vpodlesnyi/MainBoard/OUTPUT/BOM/Bill of Materials-MainBoard.xlsx

Description | Part Number | Value | Voltage | Designator | Quantity
 |  |  |  | M1, M2, M3, M4, M5, M6, M7 | 7
 | STM32F405RGT6 |  |  | DD1 | 1
3D accelerometer, 3D gyroscope, 3D magnetometer | LSM9DS1 |  |  | DD10 | 1
5-A, Wide Input Range, Step-Down Converter | TPS5450 |  |  | DD12 | 1
5-A, Wide Input Range, Step-Down Converter | TPS54560BQDDAQ1 |  |  | DD11, DD13 | 2
9-Port 10/100 Unmanaged Ethernet Switch | KSZ8999I |  |  | DD6 | 1
400-mA Low-Dropout Regulator with Reverse Current Protection | TPS73618DBV |  |  | DA4 | 1
Cтабилитрон (лавинный выпрямительный диод) односторонний | TPSMB56A |  |  | VD20, VD21 | 2
DC/DC преобразователь | P6AU/IU-3R305ELF |  |  | DD5, DD14 | 2
DIP переключатель |  |  |  | SW1, SW3, SW4 | 3
DIP переключатель |  |  |  | SW2 | 1
DIP переключатель |  |  |  | SW5 | 1
EMI Suppression Filter | B82477G4153M000 | 15мкГн |  | L5 | 1
EMI Suppression Filter | B82477G4223M000 | 22мкГн |  | L4 | 1
EMI Suppression Filter | H1164NL |  |  | T1 | 1
EMI Suppression Filter | SDR0604- 180YL | 18мкГн |  | L1, L7 | 2
EMI Suppression Filter | SDR1006-4R7ML | 4,7мкГн |  | L6 | 1
Isolated CAN Transceiver | ISO1050DW |  |  | DD3, DD4 | 2
SPI Serial Flash Memory | AT25DF021-SSH-B |  |  | DD2 | 1
TVS | PESD1CAN |  |  | DA1, DA2 | 2
TVS | SM712.TCT |  |  | DA3 | 1
Two-wire Serial EEPROM | AT24C02N-10SU-2.7 |  |  | DD7 | 1
USB 2.0 Hub and 10/100 Ethernet Controller | LAN9514I |  |  | DD8 | 1
Диод Шоттки | B560C |  |  | VD22, VD24, VD26 | 3
Диод Шоттки | MBR2H100SFT3G |  |  | VD27, VD28 | 2
Диод Шоттки | MBR0540 |  |  | VD1 | 1
Кварц. генер. 32.768 МГц (HCMOS/TTL) | KXO-V97 |  |  | G1 | 1
Кварц. генер. 32.768 МГц (HCMOS/TTL) | KXO-V97 25.0 MHz |  |  | G2, G3 | 2
Комплементарная сборка МОП | IRF7509TRPBF |  |  | VT1, VT2, VT3, VT4, VT5, VT6, VT7, VT8, VT9, VT10, VT11, VT12, VT13, VT14, VT15, VT16, VT17, VT18, VT19, VT20 | 20
Конденсатор | C3225X7R1H106K250AC | 10мк | 50В | C8, C87, C121, C128 | 4
Конденсатор | C4532C0G1H154J250KA | 0,15мк | 50В | C145, C163 | 2
Конденсатор | C4532X7R2A225M | 2,2мк | 100В | C147, C148, C149, C150, C164, C165, C166, C167 | 8
Конденсатор | CC1206KKX7RDBB471 | 470 | 2кВ | C27, C172 | 2
Конденсатор | GRM21AR72E472KW | 4700 | 250В | C143 | 1
Конденсатор | GRM21BZ71H475KE15L | 4,7мк | 50В | C156, C157 | 2
Конденсатор | GRM31CR72E104K | 0,1мк | 250В | C135, C136, C137, C138 | 4
Конденсатор | GRM155R71H102K* | 1000 | 50B | C94, C95, C98, C101 | 4
Конденсатор | GRM155R71H103K | 0,01мк | 50B | C15, C20, C120 | 3
Конденсатор | GRM155R71H103K | 0,01мк | 50B | C124, C125, C134, C153, C158, C159 | 6
Конденсатор | GRM155R71H104KE14D | 0,1мк | 50В | C3, C5, C6, C9, C10, C11, C12, C13, C14, C17, C18, C22, C23, C46, C47, C48, C49, C50, C51, C52, C53, C54, C55, C56, C57, C58, C59, C60, C61, C62, C63, C64, C65, C66, C67, C68, C69, C70, C71, C72, C73, C74, C75, C76, C79, C80, C89, C90, C91, C92, C93, C96, C97, C99, C100, C102, C103, C104, C105, C106, C107, C108, C109, C110, C111, C112, C113, C114, C115, C116, C117, C119, C122, C123, C126, C127, C129, C130, C131, C132, C133, C154, C155, C173, C174 | 85
Конденсатор | GRM155R71H104KE14D | 0,1мк | 50В | C144, C161 | 2
Конденсатор | GRM188R71C105KA12D** | 1мк | 16B | C4, C7, C16, C19, C21, C24, C88, C118 | 8
Конденсатор | GRM188R71H104KA93D | 0,1мк | 50B | C28, C29, C30, C31, C32, C33, C34, C35, C36, C37, C38, C39, C40, C41, C42, C43, C44, C45 | 18
Конденсатор | GRM188Z71C225ME43J | 2,2мк | 16B | C1, C2, C25, C26, C170, C171 | 6
Конденсатор | GRM1555C1H5R6C | 5,6 | 50B | C151 | 1
Конденсатор | GRM1555C1H102J | 1000 | 50B | C169 | 1
Конденсатор | GRM1555C1H391J | 390 | 50B | C168 | 1
Конденсатор | GRM1555C1H561J | 560 | 50B | C152 | 1
Конденсатор полярный | 293D107X9016D2TE3 | 100мк | 16В | C160 | 1
Конденсатор полярный | EEH-ZE1V151V | 150мк | 35В | C146 | 1
Конденсатор полярный | EEU-FS1K121LB | 120мк | 80В | C139, C140, C141, C142 | 4
Конденсатор полярный | TPSD157K010R0050 | 150мк | 10B | C162 | 1
Опторазвязка | FODM8801A |  |  | DA5, DA6 | 2
Приемопередатчик RS485 изолированный | ADM2582EBRWZ |  |  | DD9 | 1
Разъем - 2 конт. розетка | 559320210 |  |  | X24 | 1
Разъем - 2 конт. розетка | 559320210 |  |  | X25 | 1
Разъем - 3 конт. розетка | 559320310 |  |  | X11 | 1
Разъем - 3 конт. розетка | 559320310 |  |  | X13 | 1
Разъем - 3 конт. розетка | 559320310 |  |  | X14 | 1
Разъем - 3 конт. розетка | 559320310 |  |  | X15 | 1
Разъем - 3 конт. розетка | 559320310 |  |  | X16 | 1
Разъем - 3 конт. розетка | 559320310 |  |  | X17 | 1
Разъем - 3 конт. розетка | 559320310 |  |  | X18 | 1
Разъем - 3 конт. розетка | 559320310 |  |  | X19 | 1
Разъем - 3 конт. розетка | 559320310 |  |  | X20 | 1
Разъем - 3 конт. розетка | 559320310 |  |  | X21 | 1
Разъем - 3 конт. розетка | 559320310 |  |  | X22 | 1
Разъем - 4 конт. розетка | 559320410 |  |  | X2, X3 | 2
Разъем - 4 конт. розетка | 559320410 |  |  | X9 | 1
Разъем - 4 конт. розетка | 559320410 |  |  | X10 | 1
Разъем - 4 конт. розетка | 559320410 |  |  | X12 | 1
Разъем - 5 конт. розетка |  |  |  | X4 | 1
Разъем - 5 конт. розетка | 532580529 |  |  | X23 | 1
Разъем - 9 конт. розетка | 100616-1 |  |  | X5 | 1
Разъем - 9 конт. розетка | 100616-1 |  |  | X6 | 1
Разъем - 9 конт. розетка | 100616-1 |  |  | X7 | 1
Разъем - 9 конт. розетка | 100616-1 |  |  | X8 | 1
Разъем - 10 конт. розетка | PAVX15-2X05-H |  |  | X1 | 1
Резистор | RC0402FR-071K2 | 1,2к |  | R143 | 1
Резистор | RC0402FR-071KL | 1к |  | R65, R68, R69, R72, R73, R76, R78, R81 | 8
Резистор | RC0402FR-072K2 | 2,2к |  | R152 | 1
Резистор | RC0402FR-072K6 | 3,6к |  | R151, R156 | 2
Резистор | RC0402FR-073K01L | 3,01к |  | R52 | 1
Резистор | RC0402FR-074K3 | 4,3к |  | R141 | 1
Резистор | RC0402FR-074K7 | 4,7к |  | R123 | 1
Резистор | RC0402FR-0710KL | 10к |  | R1, R2, R9, R10, R13, R16, R17, R39, R40, R41, R48, R49, R50, R51, R93, R94, R98, R101, R106, R110, R111, R113, R114 | 23
Резистор | RC0402FR-0712K4L | 12,4к |  | R96 | 1
Резистор | RC0402FR-0712KL | 12к |  | R95 | 1
Резистор | RC0402FR-0734K8L | 34,8к |  | R140 | 1
Резистор | RC0402FR-0747RL | 47 |  | R3, R4, R5, R6, R7, R8, R102, R103, R104, R112, R115, R116, R117, R118, R119, R120, R121, R122, R124, R125, R126, R127, R128, R129, R130, R131, R132, R133, R134 | 29
Резистор | RC0402FR-0749R9L | 49,9 |  | R66, R67, R70, R71, R74, R75, R79, R80, R82, R83, R85, R86, R88, R89, R91, R92 | 16
Резистор | RC0402FR-0762RL | 62 |  | R11, R12, R14, R15, R105, R109 | 6
Резистор | RC0402FR-0775RL | 75 |  | R77, R84, R87, R90 | 4
Резистор | RC0402FR-07150RL | 150 |  | R150, R158, R159, R162, R163 | 5
Резистор | RC0402FR-07154KL | 154к |  | R142, R154 | 2
Резистор | RC0402FR-07160KL | 160к |  | R145 | 1
Резистор | RC0402FR-07160RL | 160 |  | R18, R19, R20, R21, R22, R23, R24, R25, R26, R27, R28, R29, R31, R32, R33 | 15
Резистор | RC0402FR-07330RL | 330 |  | R97, R99, R100 | 3
Резистор | RC0402FR-07560RL | 560 |  | R107, R108, R157, R160, R161, R164 | 6
Резистор | RC0603FR-070RL | 0 |  | R135, R137, R138, R139, R144, R146, R147, R148 | 8
Резистор | RC0603FR-0710KL | 10к |  | R155 | 1
Резистор | RC0603FR-0715KL | 15к |  | R153 | 1
Резистор | RC0805FR-071ML | 1М |  | R136 | 1
Резистор | RC0805FR-0710KL | 10к |  | R149 | 1
Светодиод | KPHHS-1005MGCK |  |  | VD2, VD3, VD6, VD7, VD10, VD18 | 6
Светодиод | KPHHS-1005SURCK |  |  | VD5, VD9, VD13, VD15, VD16, VD17, VD23, VD25 | 8
Светодиод | KPHHS-1005SYCK |  |  | VD4, VD8, VD11, VD12, VD14, VD19 | 6
Синфазный дроссель | DLW21SN900SQ2 |  |  | L2 | 1
Синфазный дроссель | SRF0703-1R0M | 1мкГн |  | L3 | 1
