vpodlesnyi/MainBoard/OUTPUT/SCH/MainBoard.PDF

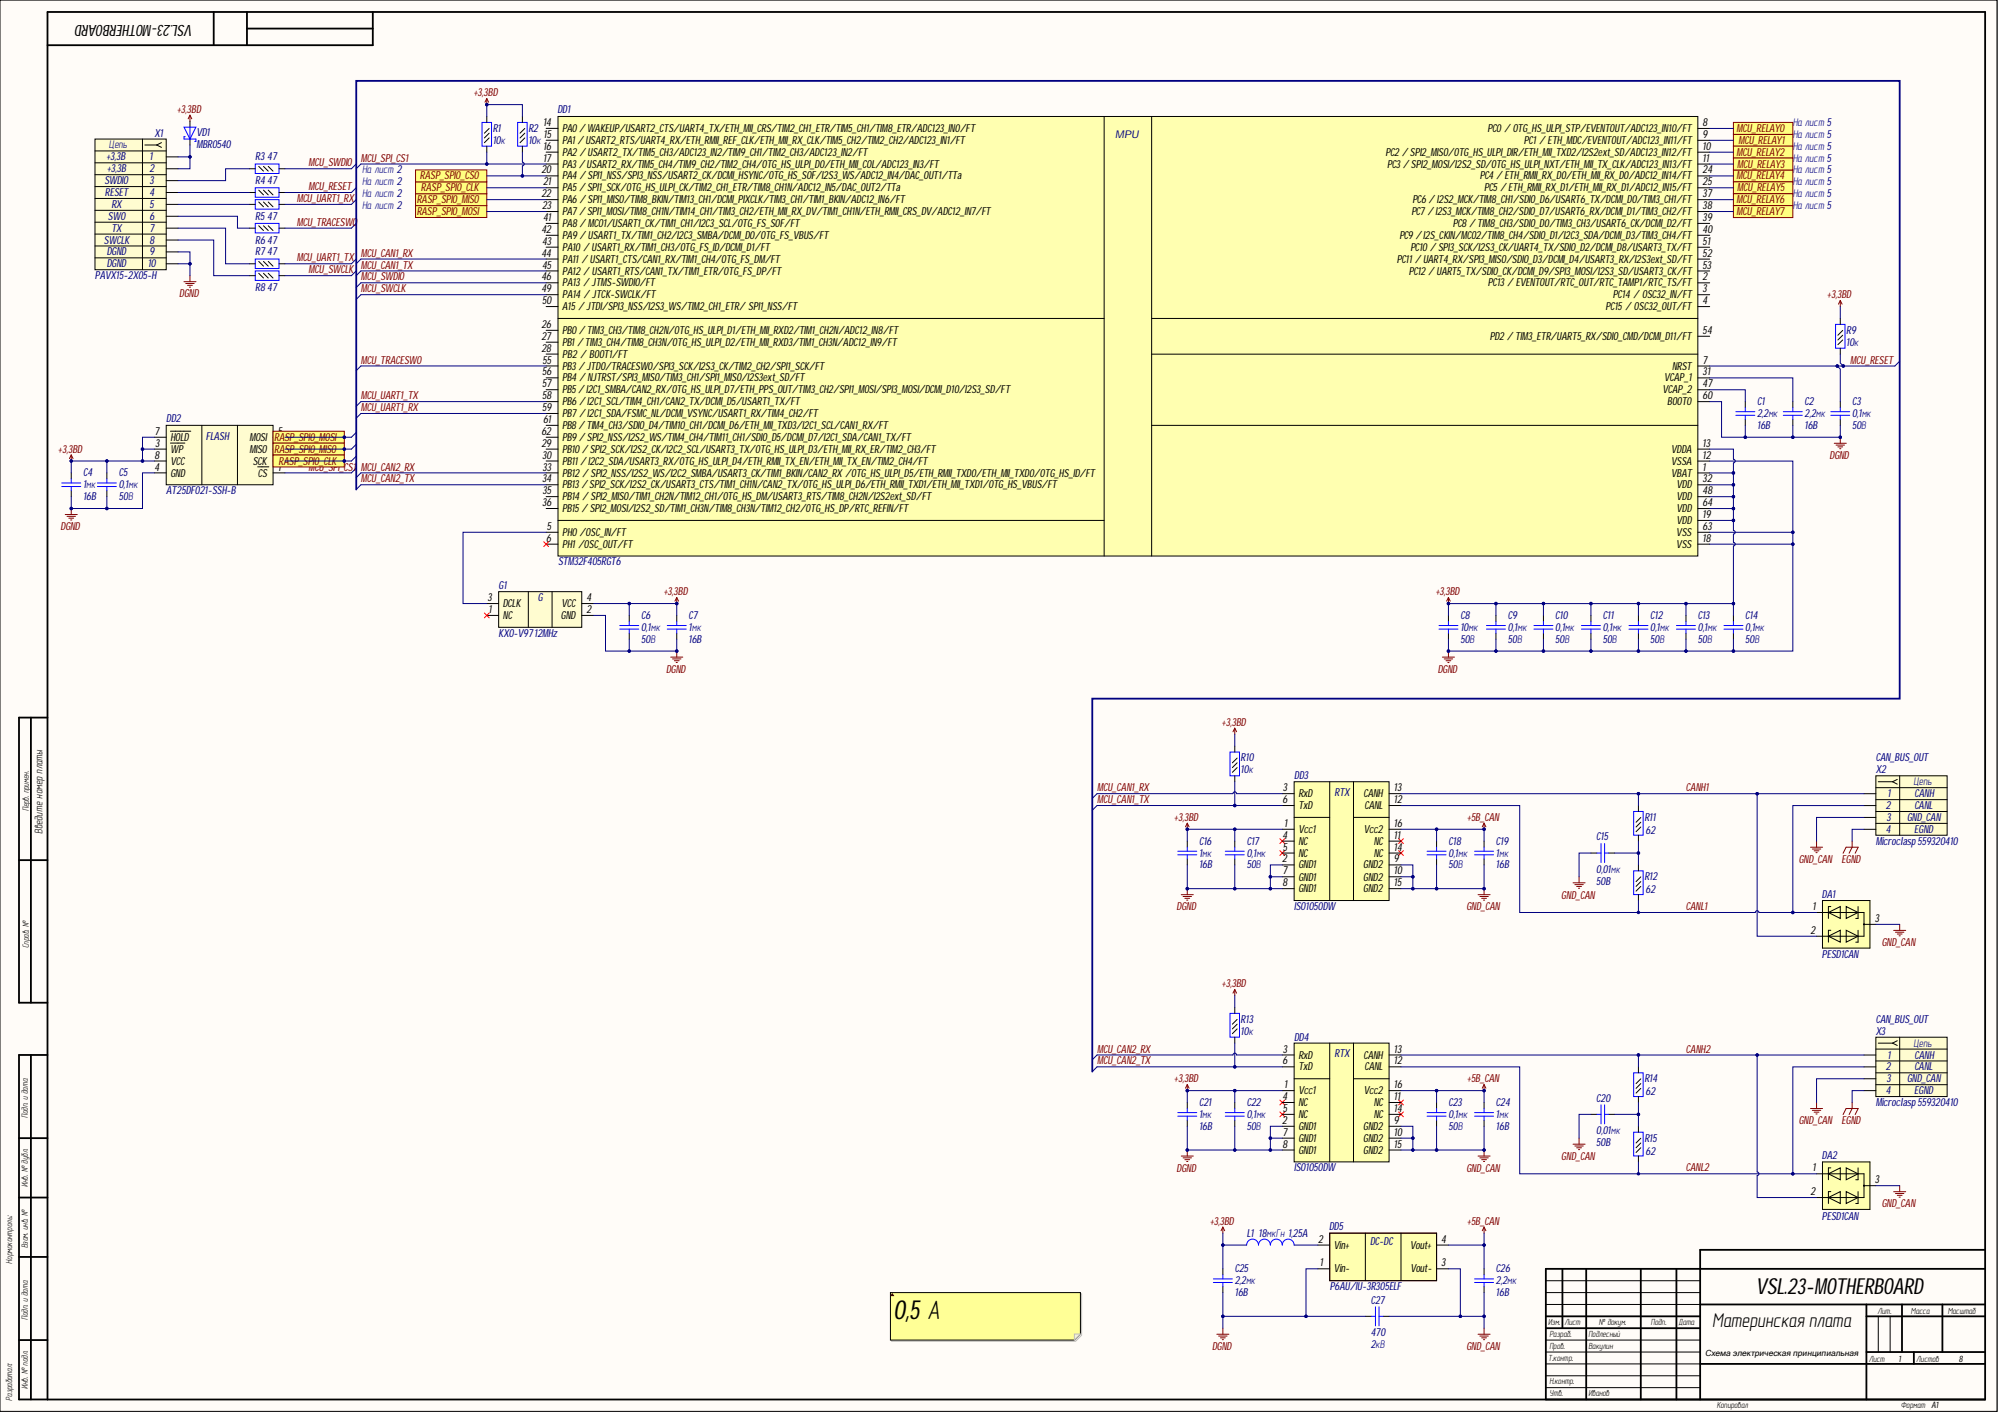
[picture p1: page 1]

Инв. № подл. Инв. № дубл. Подп. и дата Взам. инв. № Подп. и дата Перв. примен. Справ. №

Цепь
CANH

1234 | CANL

GND_CAN
EGND

RxD TxD | RTX

Vcc1 NC NC GND1 GND1 GND1 | GND2

7 | 10

VSL.23-MOTHERBOARD

Материнская плата Схема электрическая принципиальная | Лит

Пров . | Вакулин
Т .контр . | | Лис т | Листов

Н .контр .
Утв . | Иванов

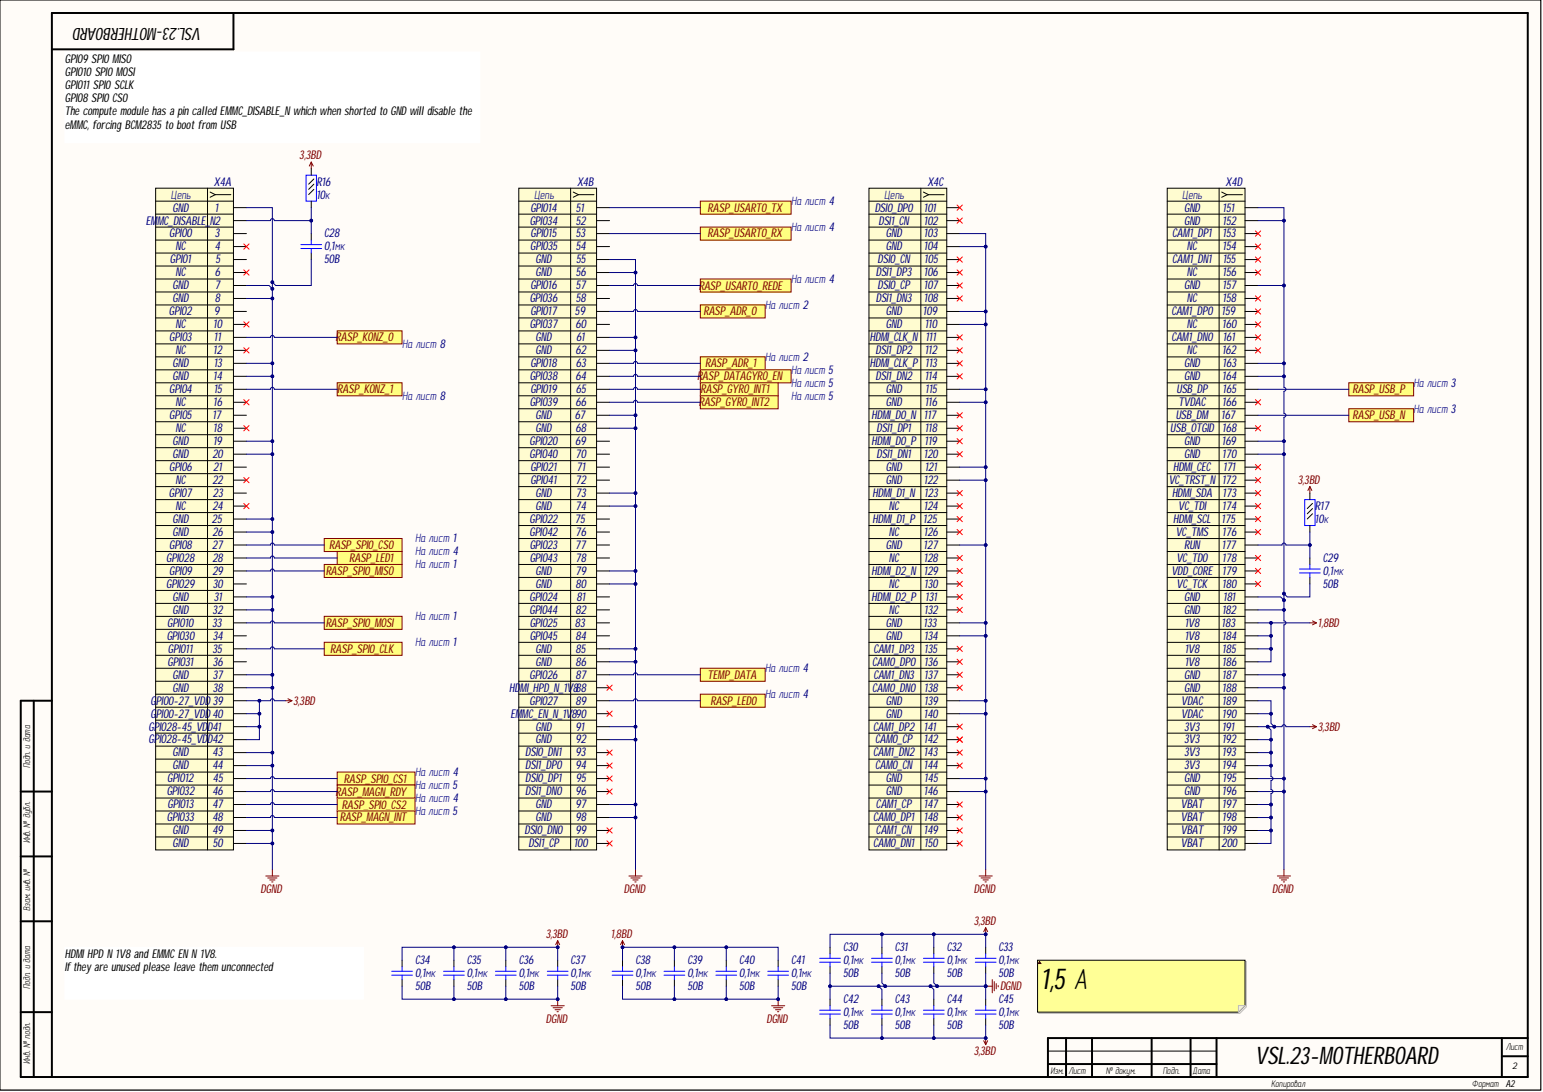
[picture p2: page 2]

GPIO9 SPI0 MISO
GPIO10 SPI0 MOSI
GPIO11 SPI0 SCLK
GPIO8 SPI0 CS0
The compute module has a pin called EMMC_DISABLE_N which when shorted to GND will disable the
eMMC, forcing BCM2835 to boot from USB

VSL.23-MOTHERBOARD в. № подл. Инв. № дубл. Подп. и дата Взам. инв. №

HDMI HPD N 1V8 and EMMC EN N 1V8.
If they are unused please leave them unconnected

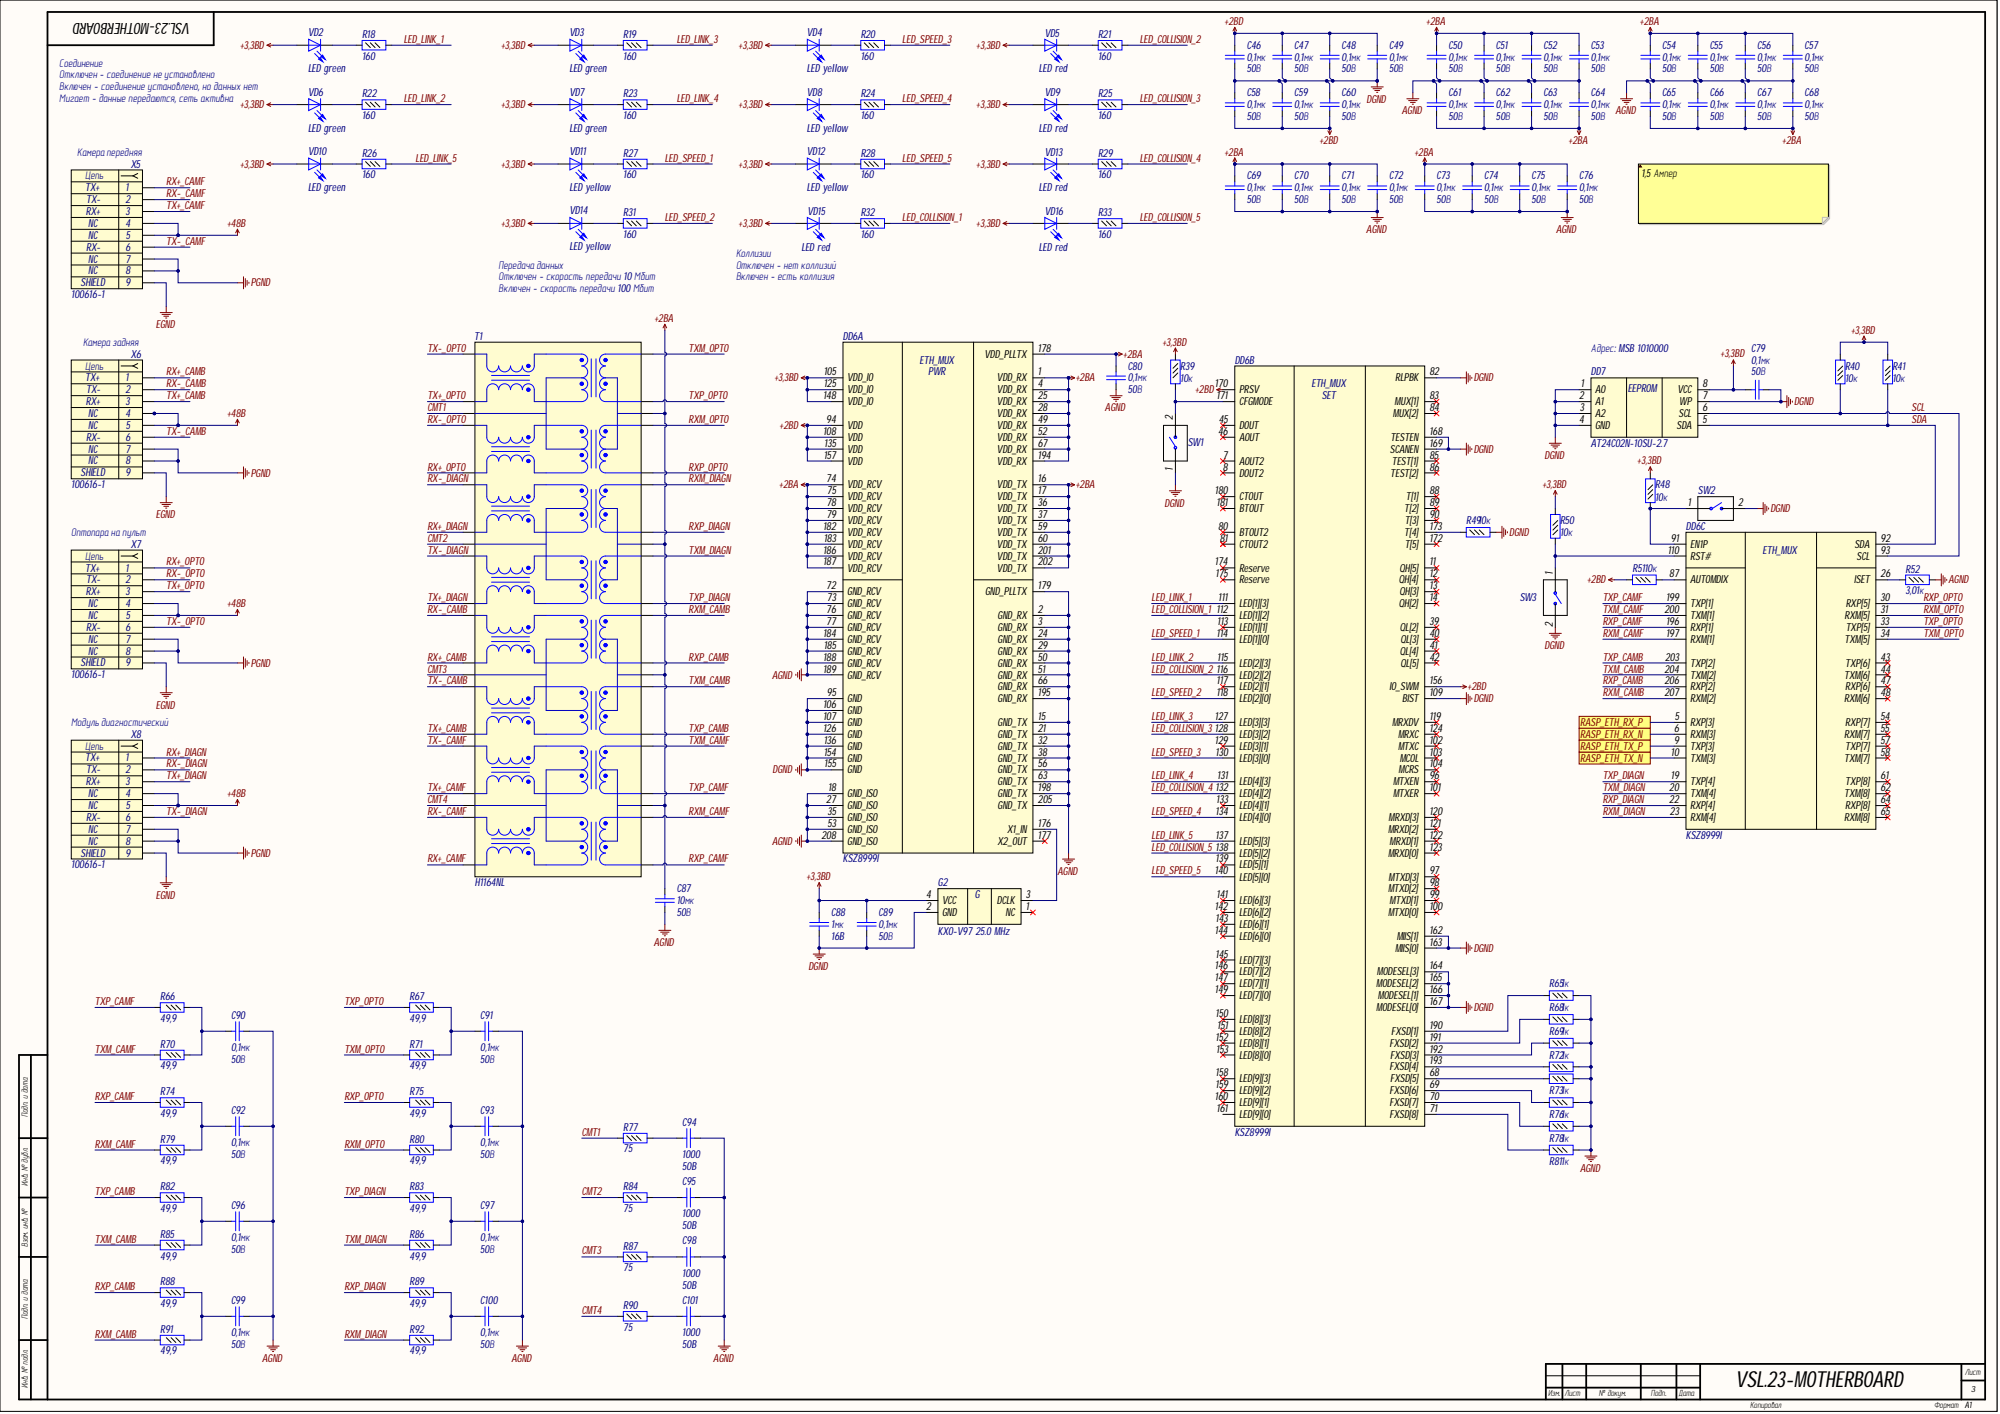
[picture p3: page 3]

Соединение
Отключен - соединение не установлено
Включен - соединение установлено, но данных нет

Цепь
TX+ | 1
TX- | 2
RX+ | 3
NC | 4
NC | 5
RX- | 6
NC | 7
NC | 8
SHIELD | 9

Передачаданных
Отключен - скорость передачи 10 Мбит
Включен - скорость передачи 100 Мбит

VSL.23-MOTHERBOARD в. № подл. Инв. № дубл. Подп. и дата Взам. инв. №

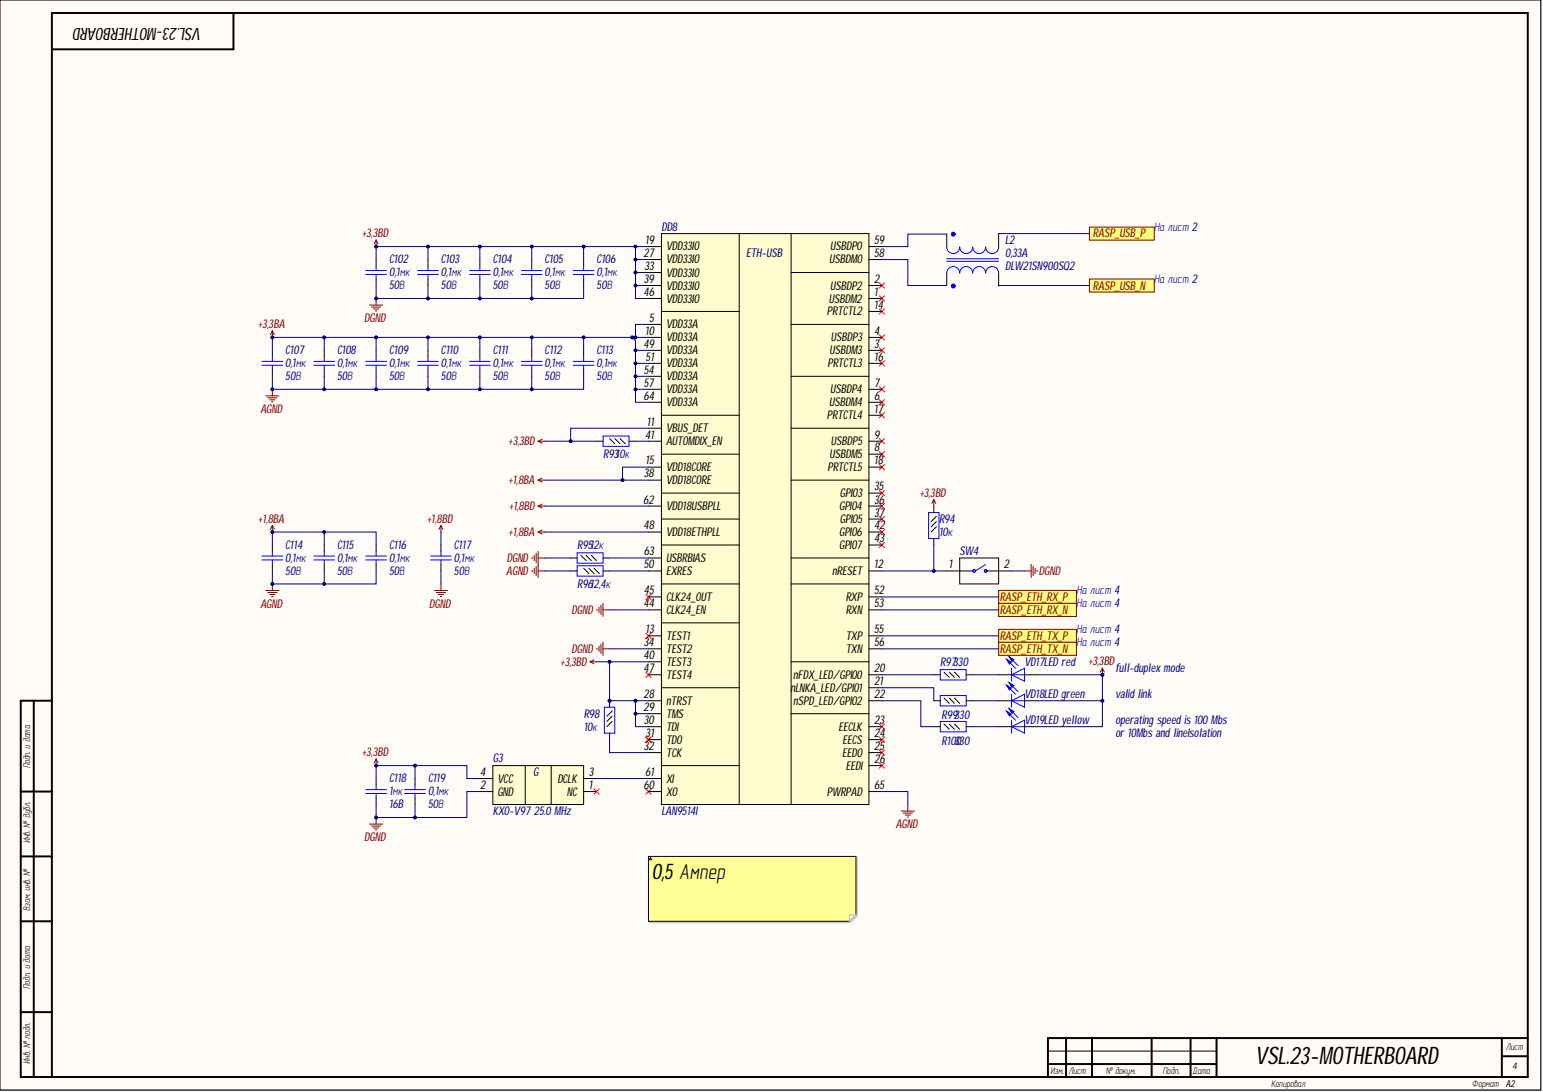
[picture p4: page 4]

VDD33A 5 | 4
VDD33A 10 | USBDP3 USBDM3 PRTCTL3
VDD33A 49 | 3
VDD33A 51 | | 16

operating speed is 100 Mbs
or 10Mbs and lineIsolation

VSL.23-MOTHERBOARD в. № подл. Инв. № дубл. Подп. и дата Взам. инв. №

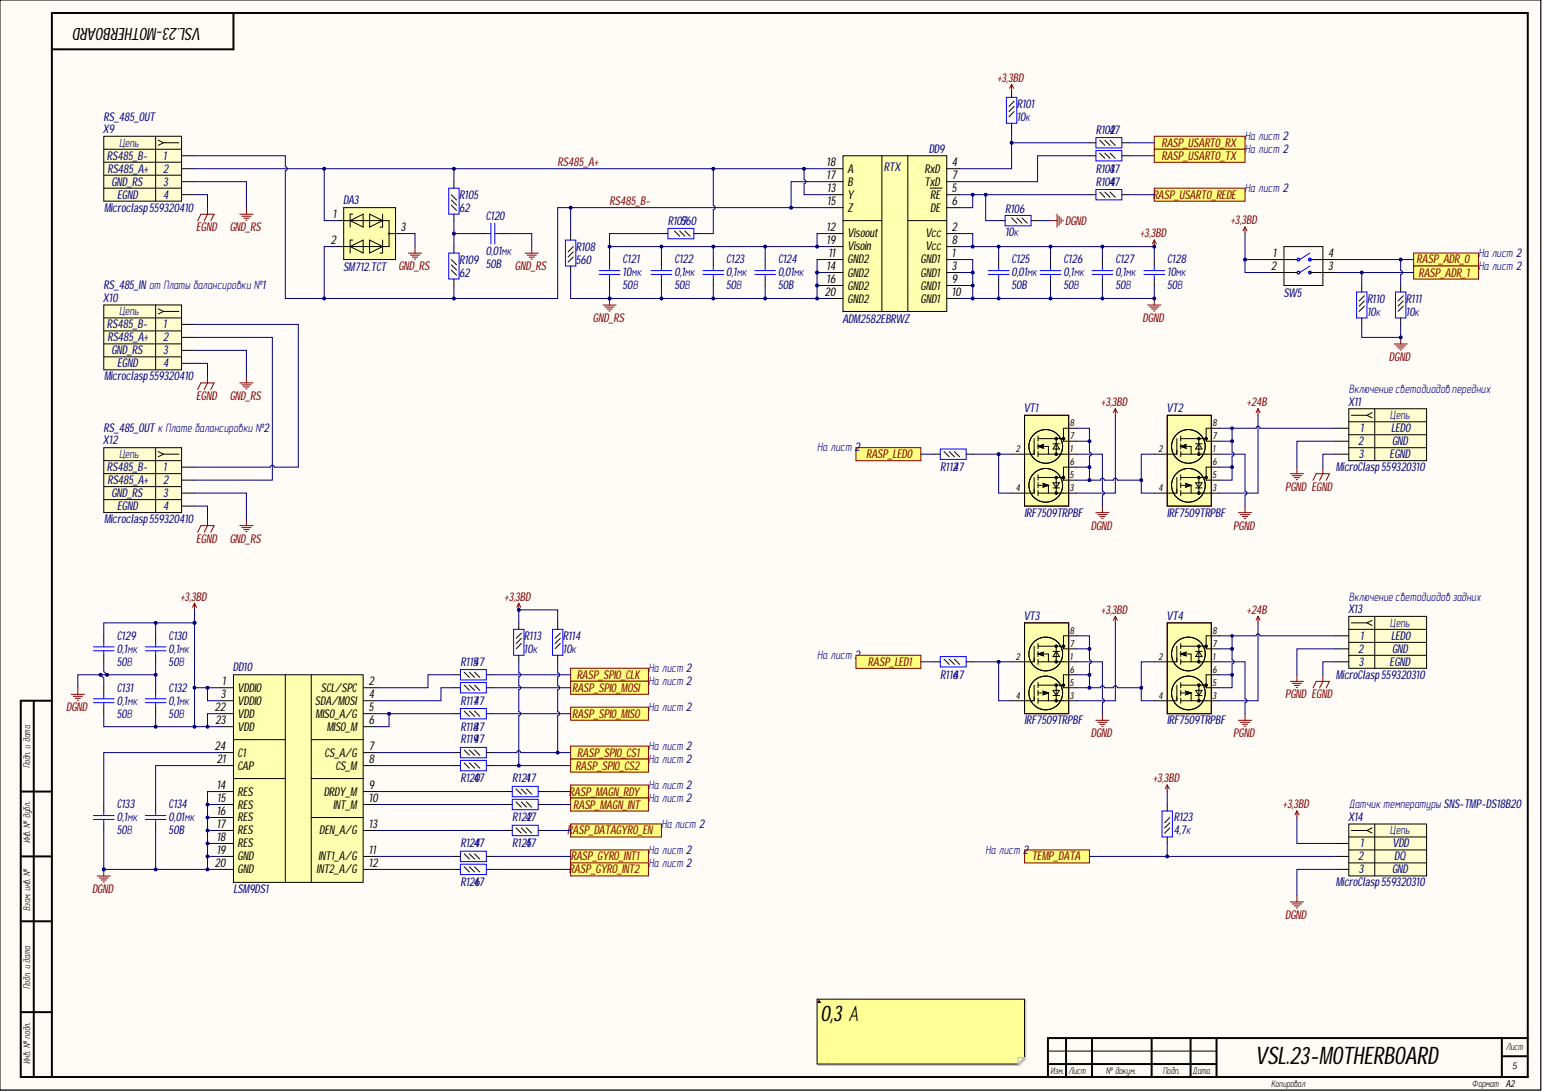
[picture p5: page 5]

B 17 A 18 | RTX

RS485_A+ | 2
GND_RS | 3

19
GND2 11

Цепь
RS485_B- | 1
EGND | 4

1 | LED0
2 | GND

VSL.23-MOTHERBOARD в. № подл. Инв. № дубл. Подп. и дата Взам. инв. №

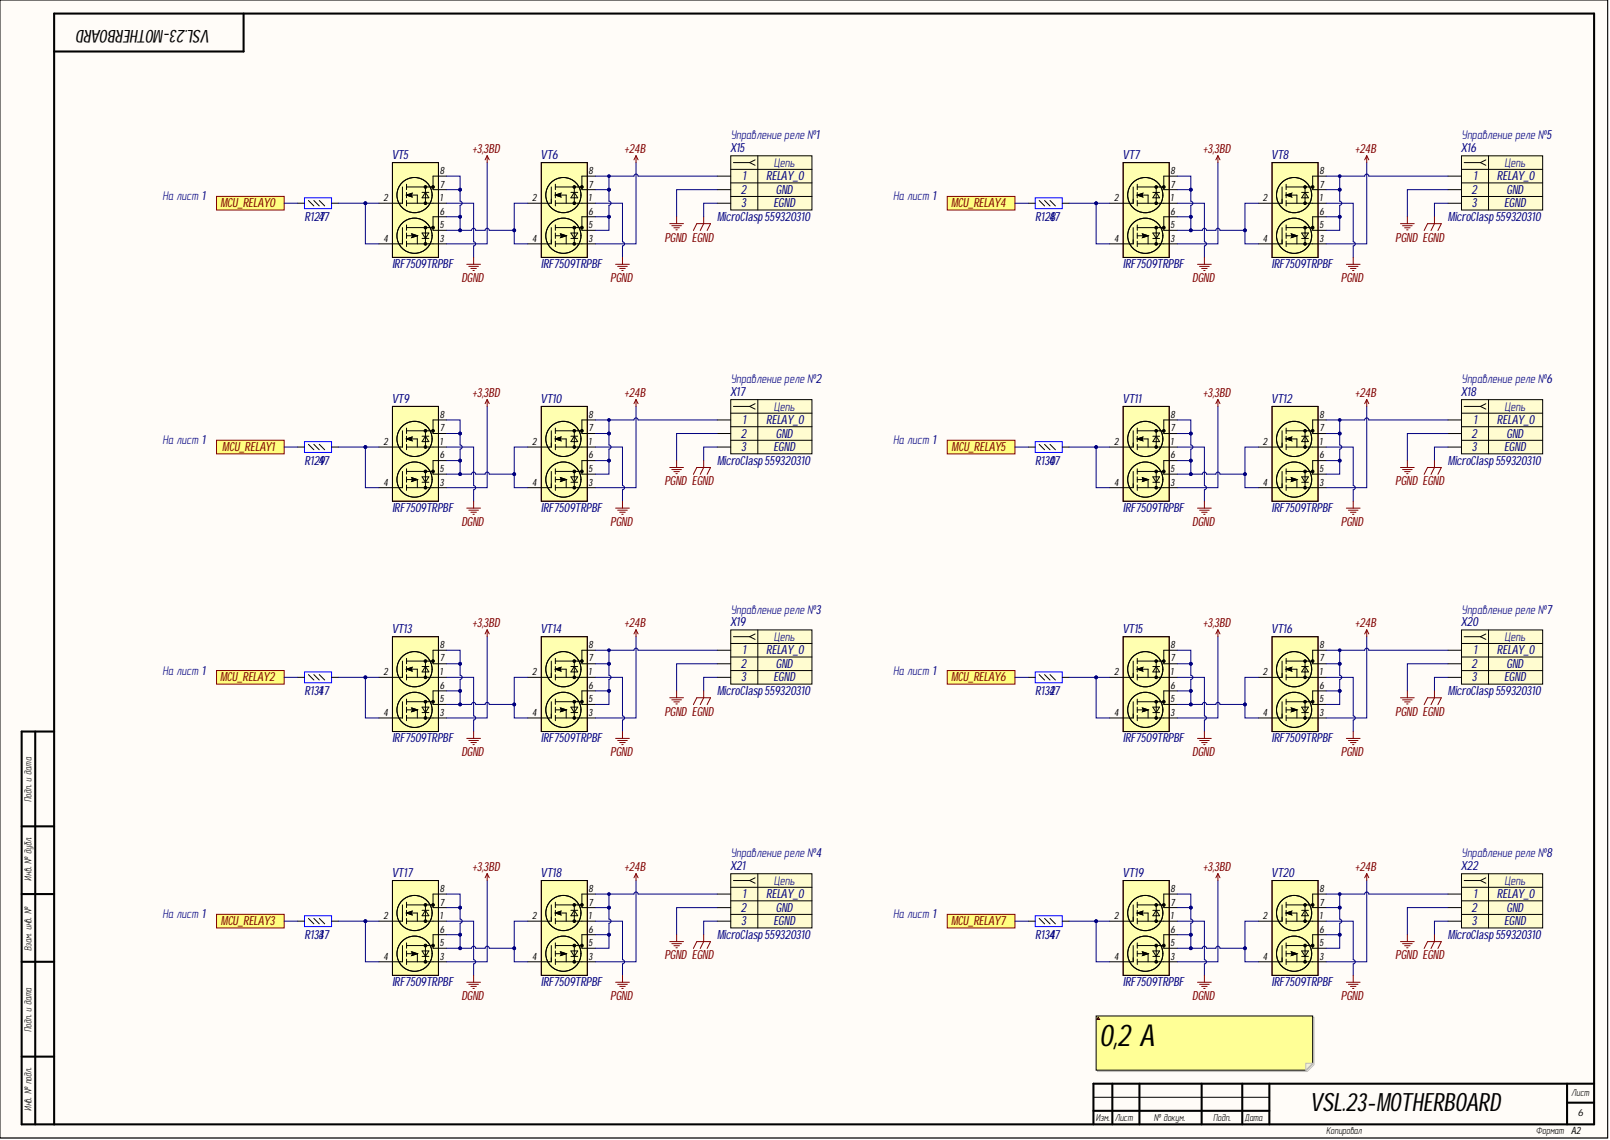
[picture p6: page 6]

VSL.23-MOTHERBOARD в. № подл. Инв. № дубл. Подп. и дата Взам. инв. №

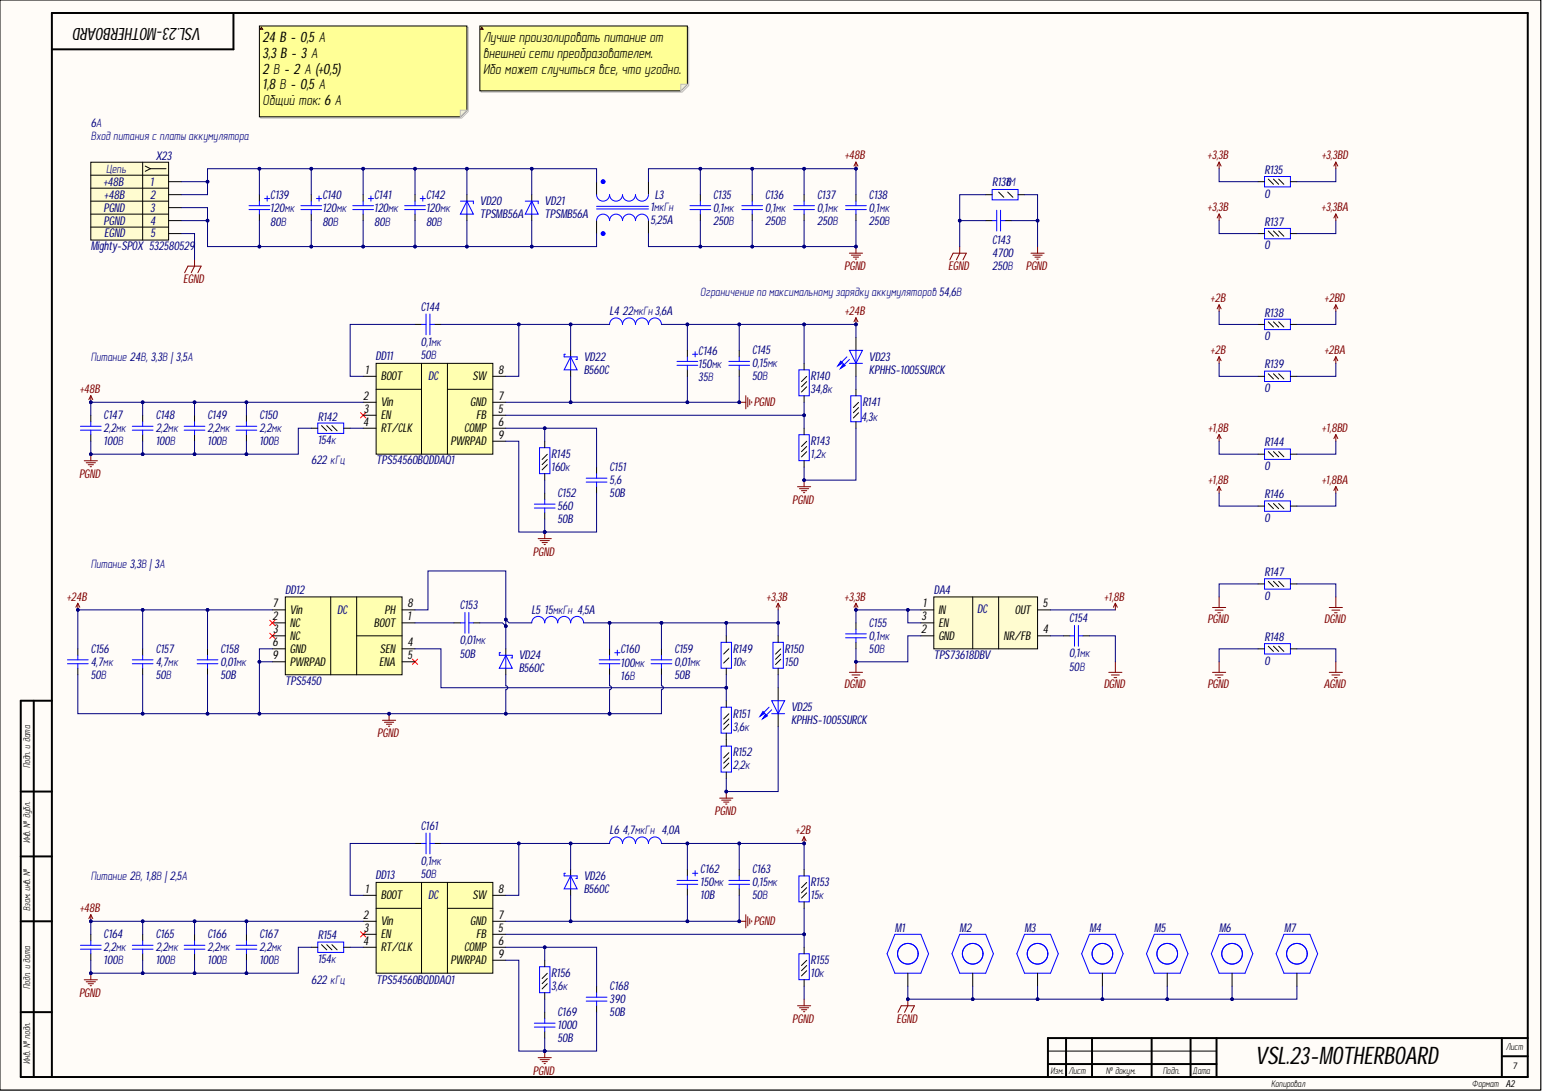
[picture p7: page 7]

Лучше произолировать питание от
внешней сети преобразователем.
Ибо может случиться все, что угодно.

Вход питания с платы аккумулятора

Цепь
+48B | 1
+48B | 2
PGND | 3
PGND | 4
EGND | 5

Ограничение по максимальному зарядку аккумуляторов 54,6В

VSL.23-MOTHERBOARD в. № подл. Инв. № дубл. Подп. и дата Взам. инв. №

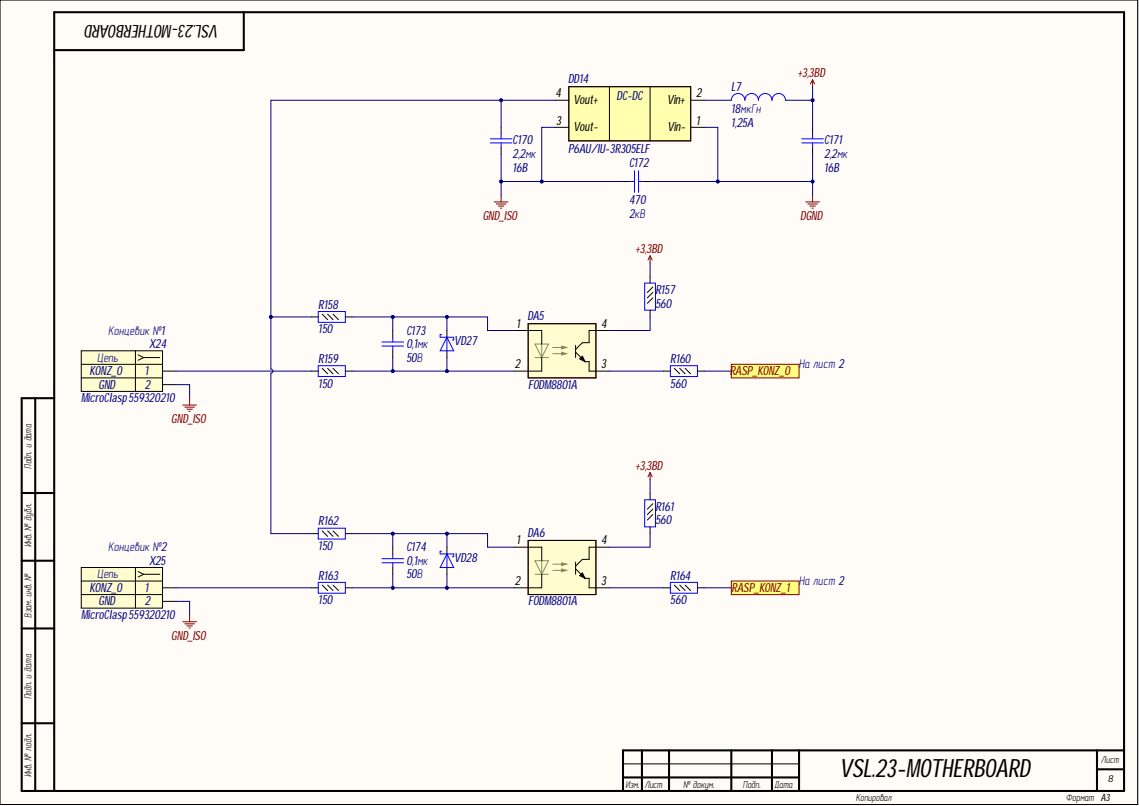
[picture p8: page 8]

Vout+ | DC-DC

R158 | Vout- 3

VSL.23-MOTHERBOARD в. № подл. Инв. № дубл. Подп. и дата Взам. инв. №
