vpodlesnyi/MainBoard/(list of files, drawings)

Other design files:
MainBoard.PrjPcb
SCH/MainBoard_ETH.SchDoc
SCH/MainBoard_ETH_RASP.SchDoc
SCH/MainBoard_KONZEVIC.SchDoc
SCH/MainBoard_MCU.SchDoc
SCH/MainBoard_PERIPH.SchDoc
SCH/MainBoard_PWR.SchDoc
SCH/MainBoard_RASP.SchDoc
SCH/MainBoard_RELAY.SchDoc
