vpodlesnyi/MainBoard/(commit log)

2022-08-02 Uploaded edited documents.
    [Bill of Materials-MainBoard.xlsx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]
2022-08-02 Updated files.
    [Bill of Materials-MainBoard.xlsx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]
